dnx98/TCC_FAG/docs/MONTAGEM GATEWAY.jpeg

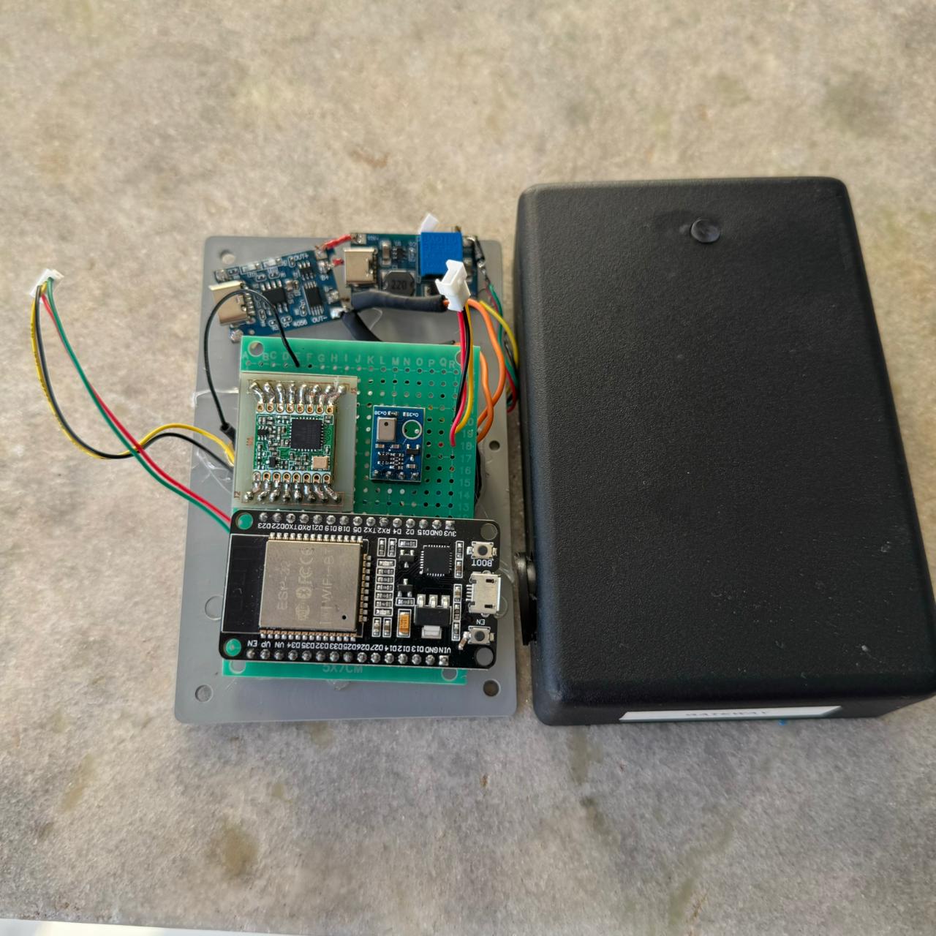
docs/MONTAGEM GATEWAY.jpeg
