dnx98/TCC_FAG/docs/MONTAGEM NÓ.jpeg

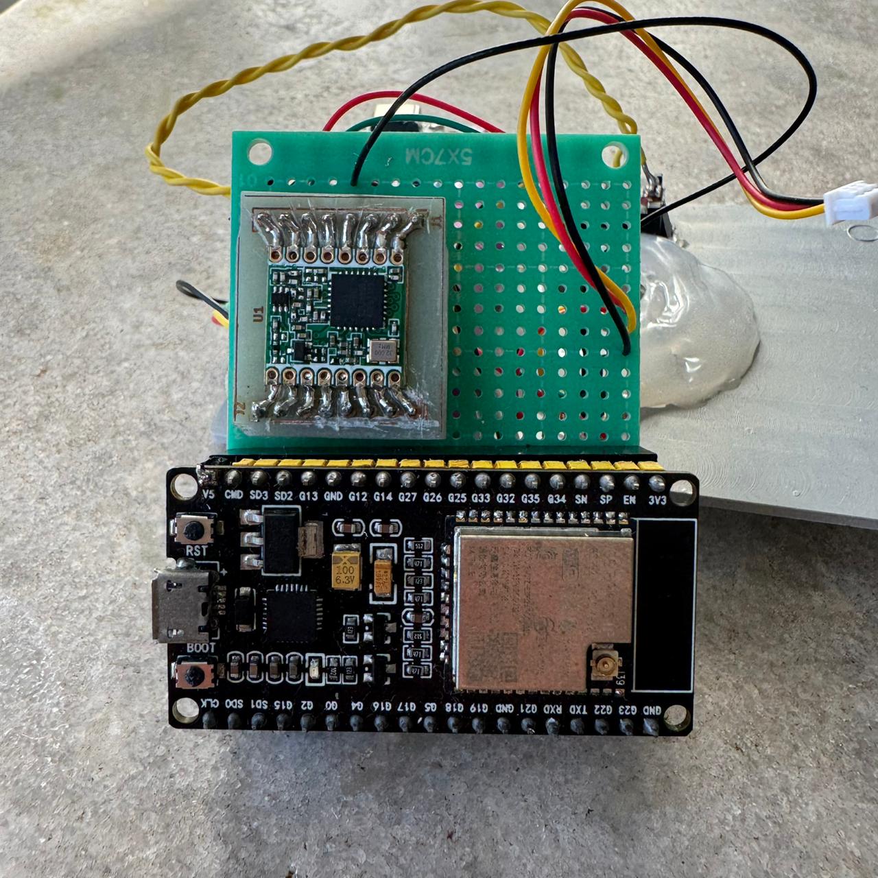
docs/MONTAGEM NÓ.jpeg
