dnx98/TCC_FAG/node_red/climaCSV.png

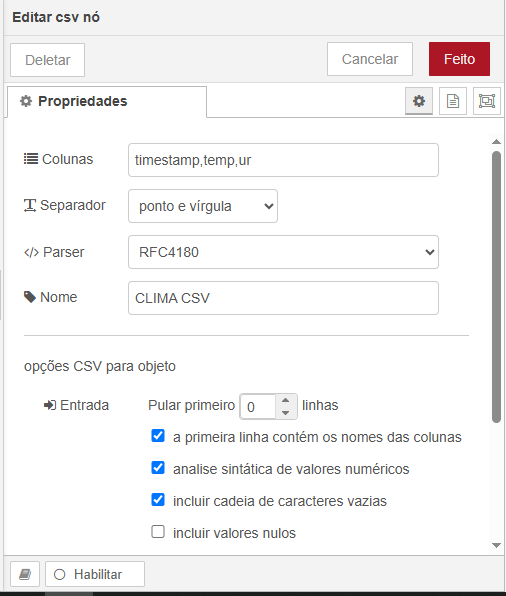
node_red/climaCSV.png
