dnx98/TCC_FAG/node_red/conexao_node.png

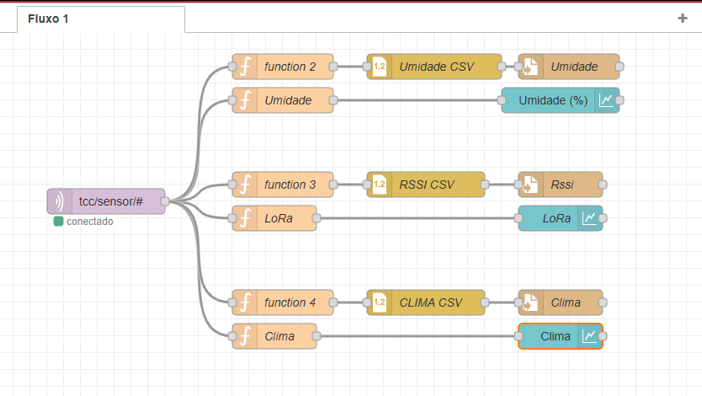
node_red/conexao_node.png
