dnx98/TCC_FAG/node_red/grafico_clima.png

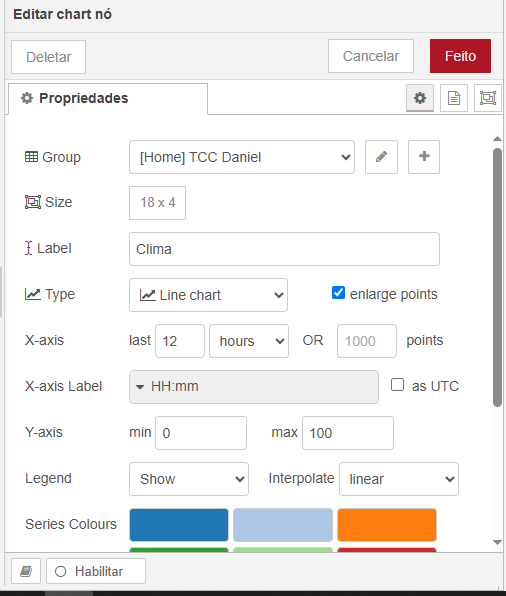
node_red/grafico_clima.png
