dnx98/TCC_FAG/node_red/grafico_LoRa.png

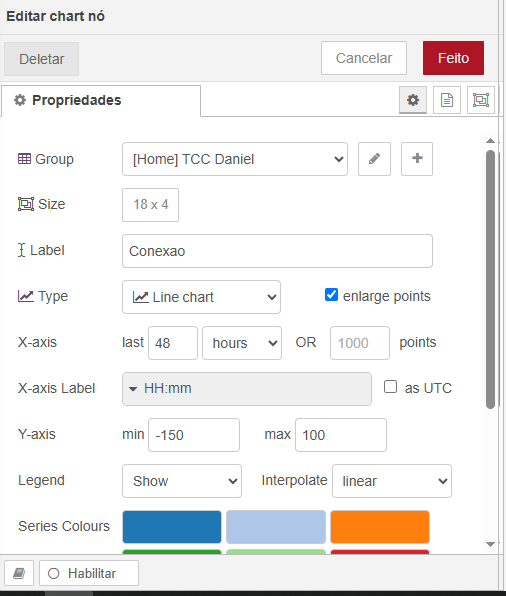
node_red/grafico_LoRa.png
