dnx98/TCC_FAG/node_red/grafico_umidade.png

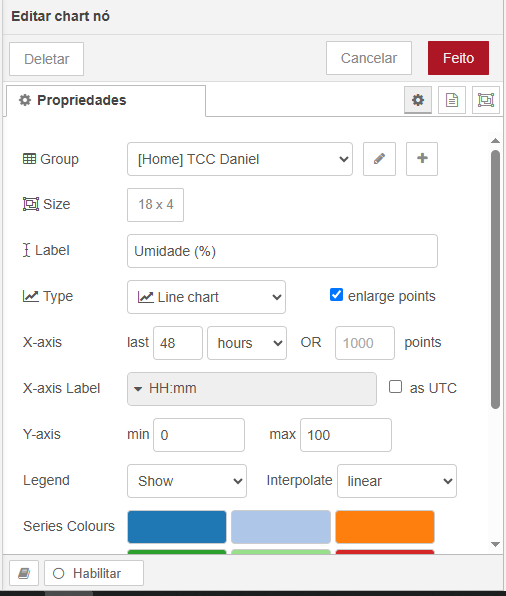
node_red/grafico_umidade.png
