dnx98/TCC_FAG/node_red/rssiCVS.png

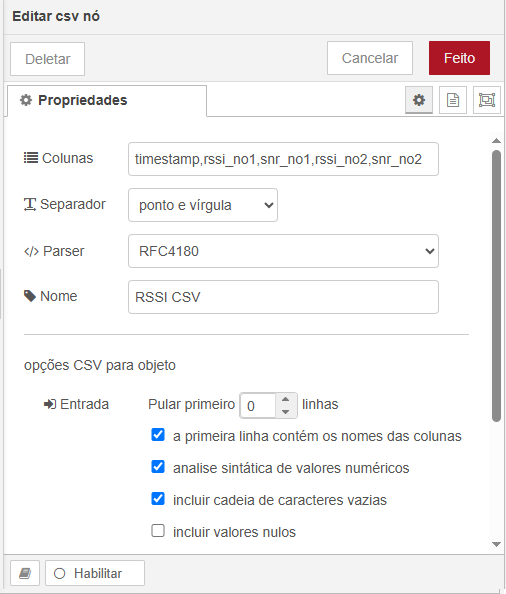
node_red/rssiCVS.png
