dnx98/TCC_FAG/node_red/umidadeCSV.png

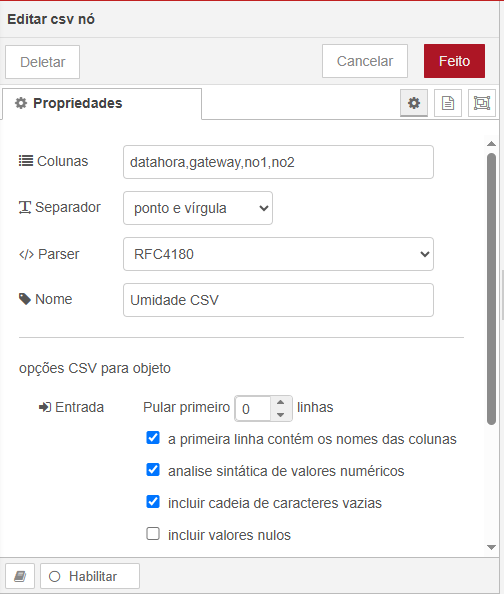
node_red/umidadeCSV.png
