dnx98/TCC_FAG/docs/ESQUEMÁTICO GATEWAY.pdf

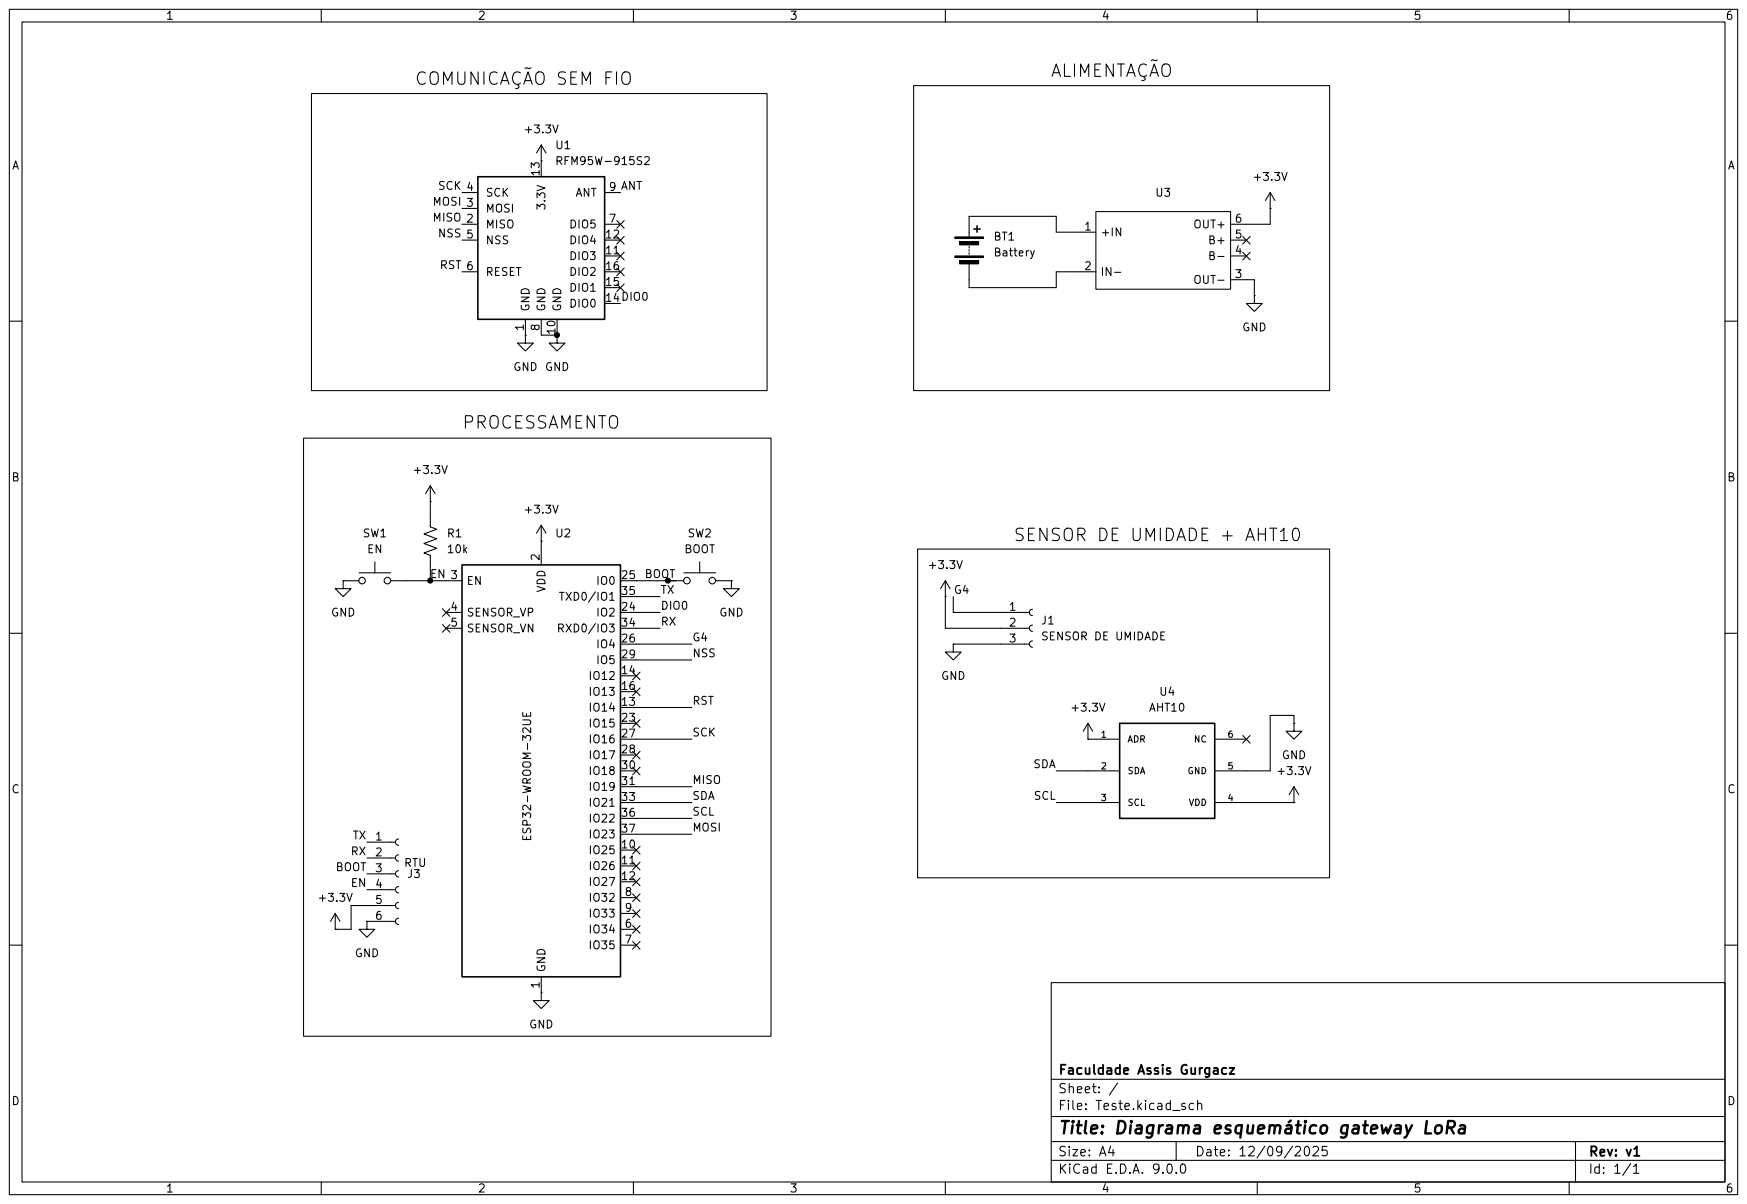
[picture p10: page 1]
