dnx98/TCC_FAG/docs/ESQUEMÁTICO NÓ.pdf

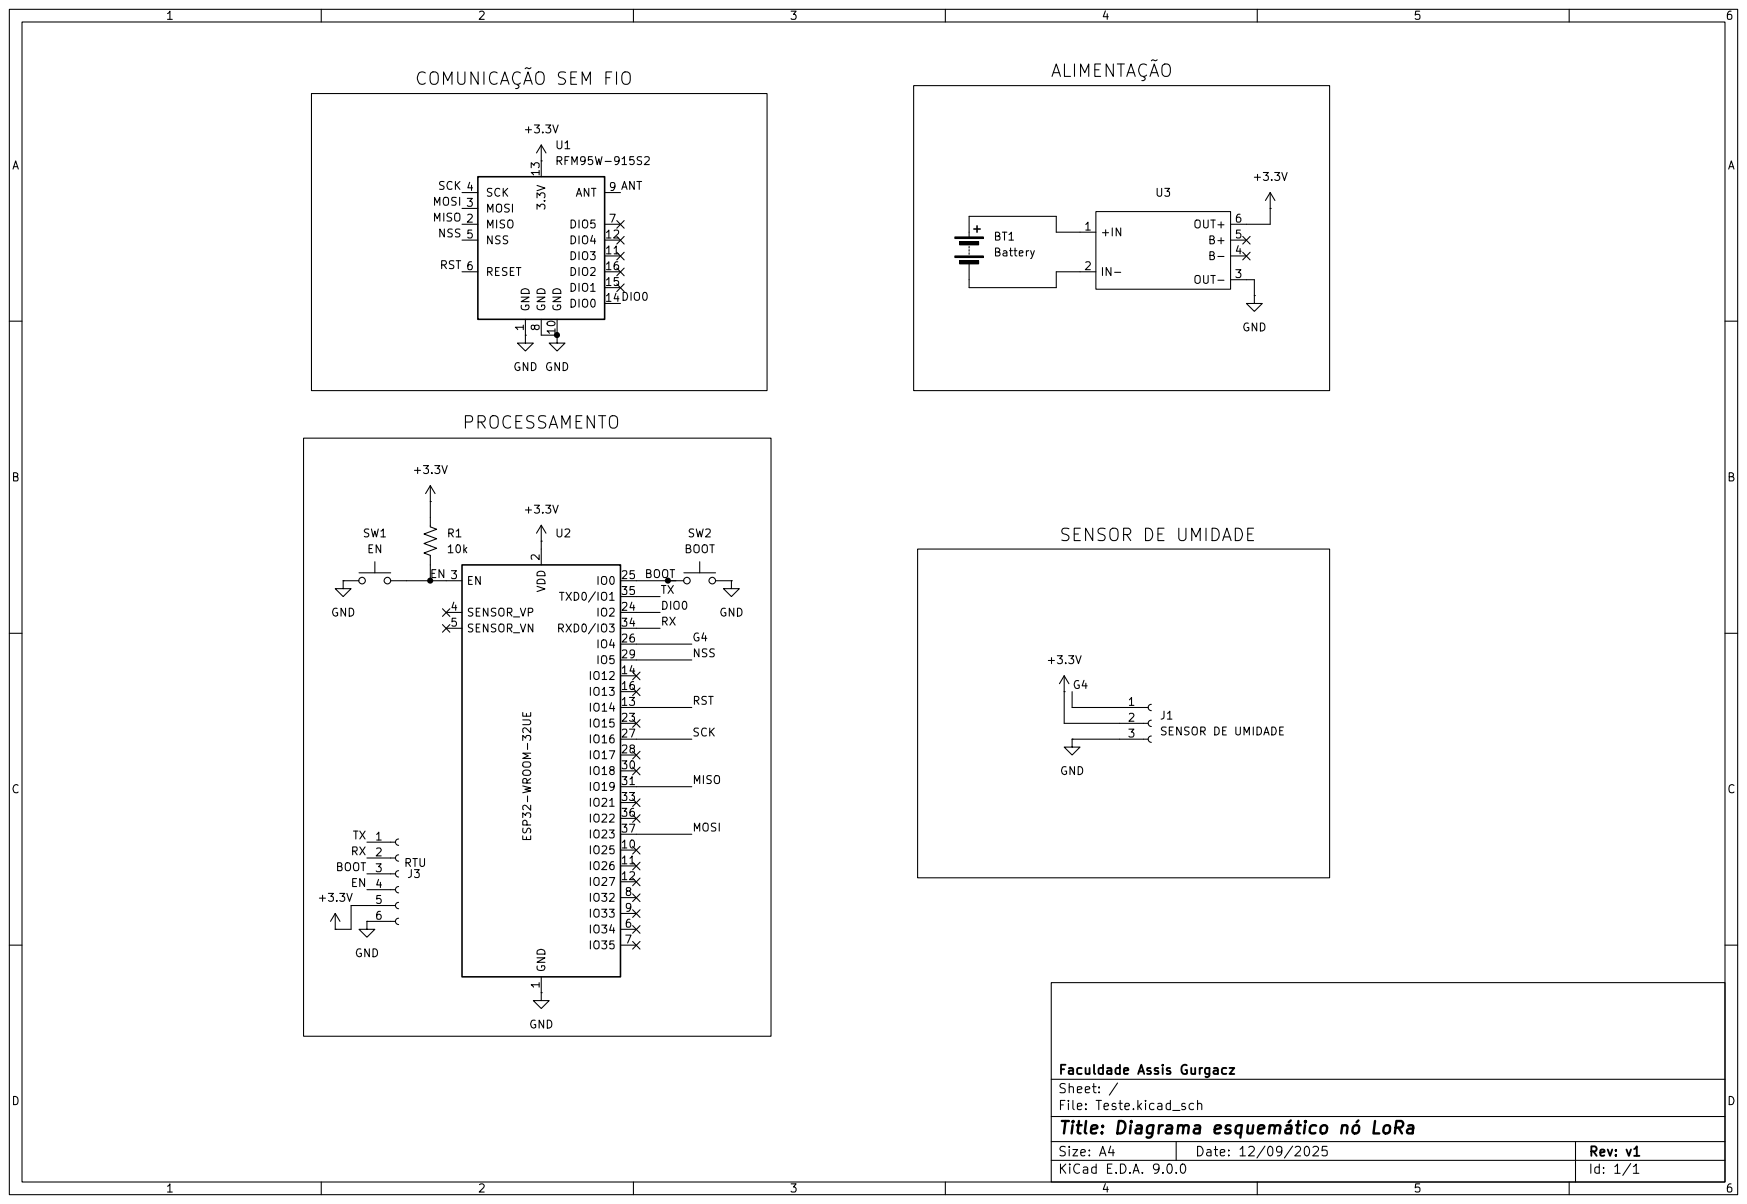
[picture p11: page 1]
